Dragon-S1/Smart-Sensing-for-IoT-IR-Touch-detection-smIRtouch-/cs6650-ppt.pdf

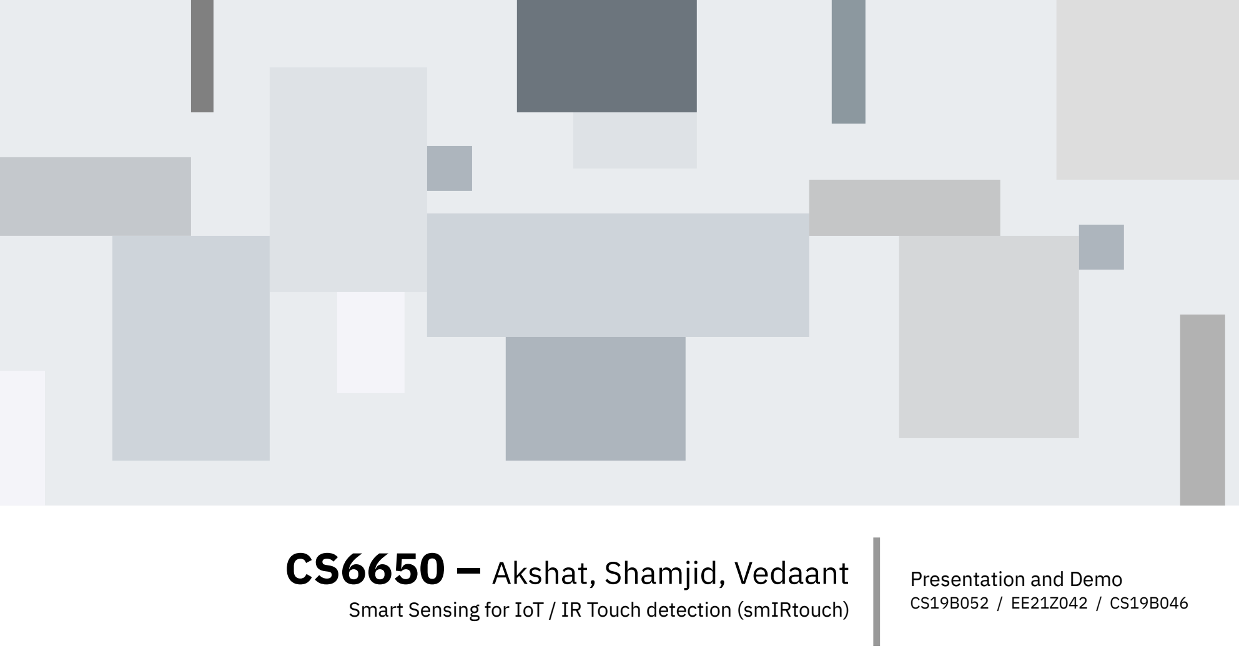
[picture p5: figure]
CS6650 – Akshat, Shamjid, Vedaant; Presentation and Demo

Smart Sensing for IoT / IR Touch detection (smIRtouch)

## The Quest

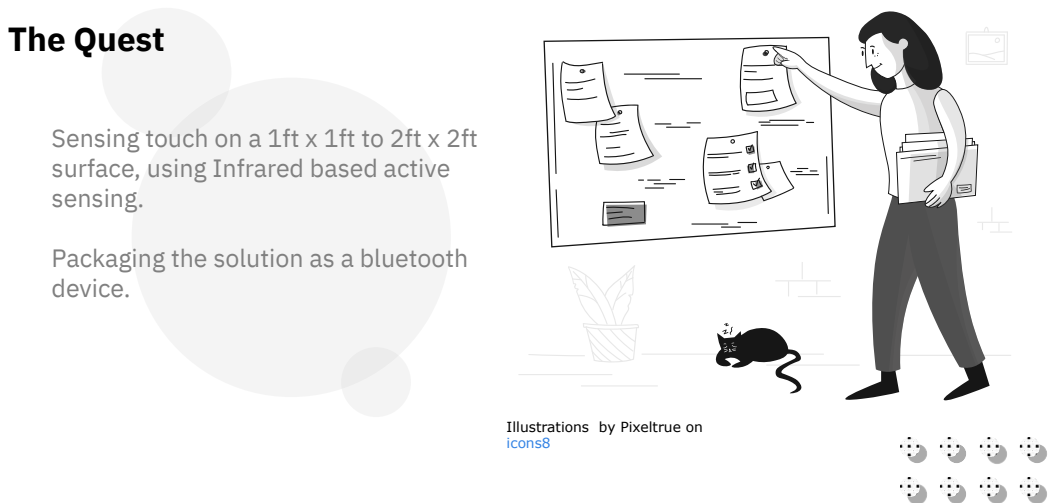
[picture p6: page 2]

Sensing touch on a 1ft x 1ft to 2ft x 2ft
surface, using Infrared based active
sensing.

Packaging the solution as a bluetooth
device.

Illustrations by Pixeltrue (https://icons8.com/illustrations/author/5ec7b0e101d0360016f3d1b3) on
icons8 (https://icons8.com/)

# The Path

(variants)

1. Single Bar (single line)
2. Double Bar (2 lines)
3. Double Bar (4 lines)
4. Creating a script that digitizes the sensed values

- IR LEDs are highly directional.
- IR phototransistors have been used extensively in industry, for measuring high frequency IR pulses in remote applications and IR based touch technology has been used in Smart Class solutions
- Using IR based technology implies less dependence on kind of surface, and rugged build
- The intensity variation for distances of 1ft for our 3mm LEDs was fair, and enough for application as a touch screen.

some useful properties

the double bar approach

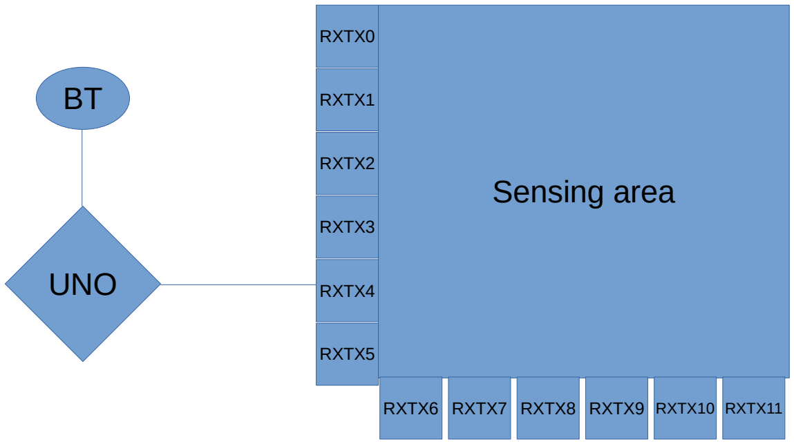
[picture p7: figure]
Sensing area; RXTX0; RXTX1; RXTX2; RXTX3; RXTX4; RXTX5; UNO; RXTX6; RXTX7; RXTX8; RXTX9; RXTX10; RXTX11

tx

rx

F

True (600 > VTh)

RX: IR phototransistor
(reads amount of IR falling on it) TX: IR LED
(highly directional source of IR)

TX sends.
If Finger obstructs path of TX, IR bounces off it and goes to RX. We get a high analog read.

We scan for each horizontal And vertical line.

Due to UNO limitations we
Use a Mux (12-1 and 12-3).

the double bar approach

RX: IR phototransistor
(reads amount of IR falling on it) TX: IR LED
(highly directional source of IR)

TX sends.
If Finger obstructs path of TX, IR bounces off it and goes to RX. We get a high analog read.

We scan for each horizontal And vertical line.

the single bar approach

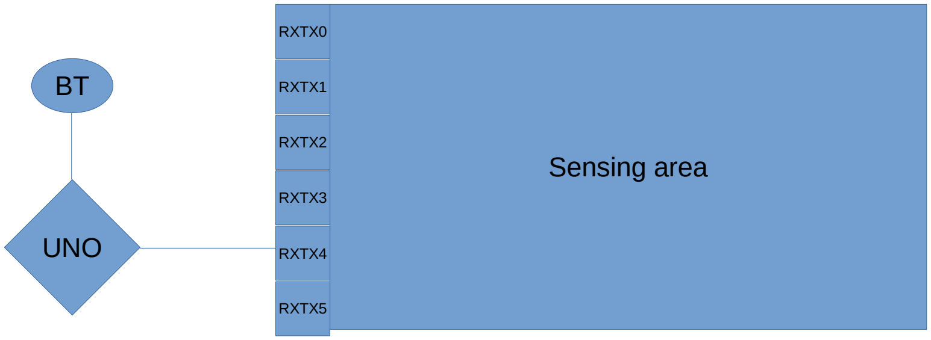
[picture p8: figure]
Sensing area; RXTX0; RXTX1; RXTX2; RXTX3; RXTX4; RXTX5; UNO

Rx: IR phototransistor

Tx: IR LED

BT: HC-05 Bluetooth Shield

the single bar approach

F

Rx: IR phototransistor

Tx: IR LED
BT: HC-05 Bluetooth Shield 600

tx

rx

the single bar approach

Rx: IR phototransistor

Tx: IR LED

BT: HC-05 Bluetooth Shield

In the double bar models, we get a discrete output, if we have H x V RXTX pairs, we get the same resolution of H x V.

In the single bar model, for vertical axis, we get discrete output for the N units present. For the horizontal axis, we split the range into N discrete intervals (during calibration we find out the range of sensing for the distance). In our tests, interpolation seemed to give good values (i.e. resolution of 2N x 2N for N sensors).

digitizing

calibration

We need to remove the ambient IR component for the readings, and know the minimum and maximum values for a distance. For these, we perform calibration before we begin sensing.

We get the base value (default when sensing nothing), and any displaced values (extremes of values when touched).
